xx0x/vk49/README.md

# VK49 2.0

Made by Vaclav Mach (vaclavmach at hotmail.cz)

## License 

- Hardware: CC BY-SA 4.0
- Software: CC BY-SA 4.0
- Original sounds: Copyrighted
