xx0x/vk49/hardware/VK49_2.0.brd

## EAGLE design hardware/VK49_2.0.brd (2023-06-04)

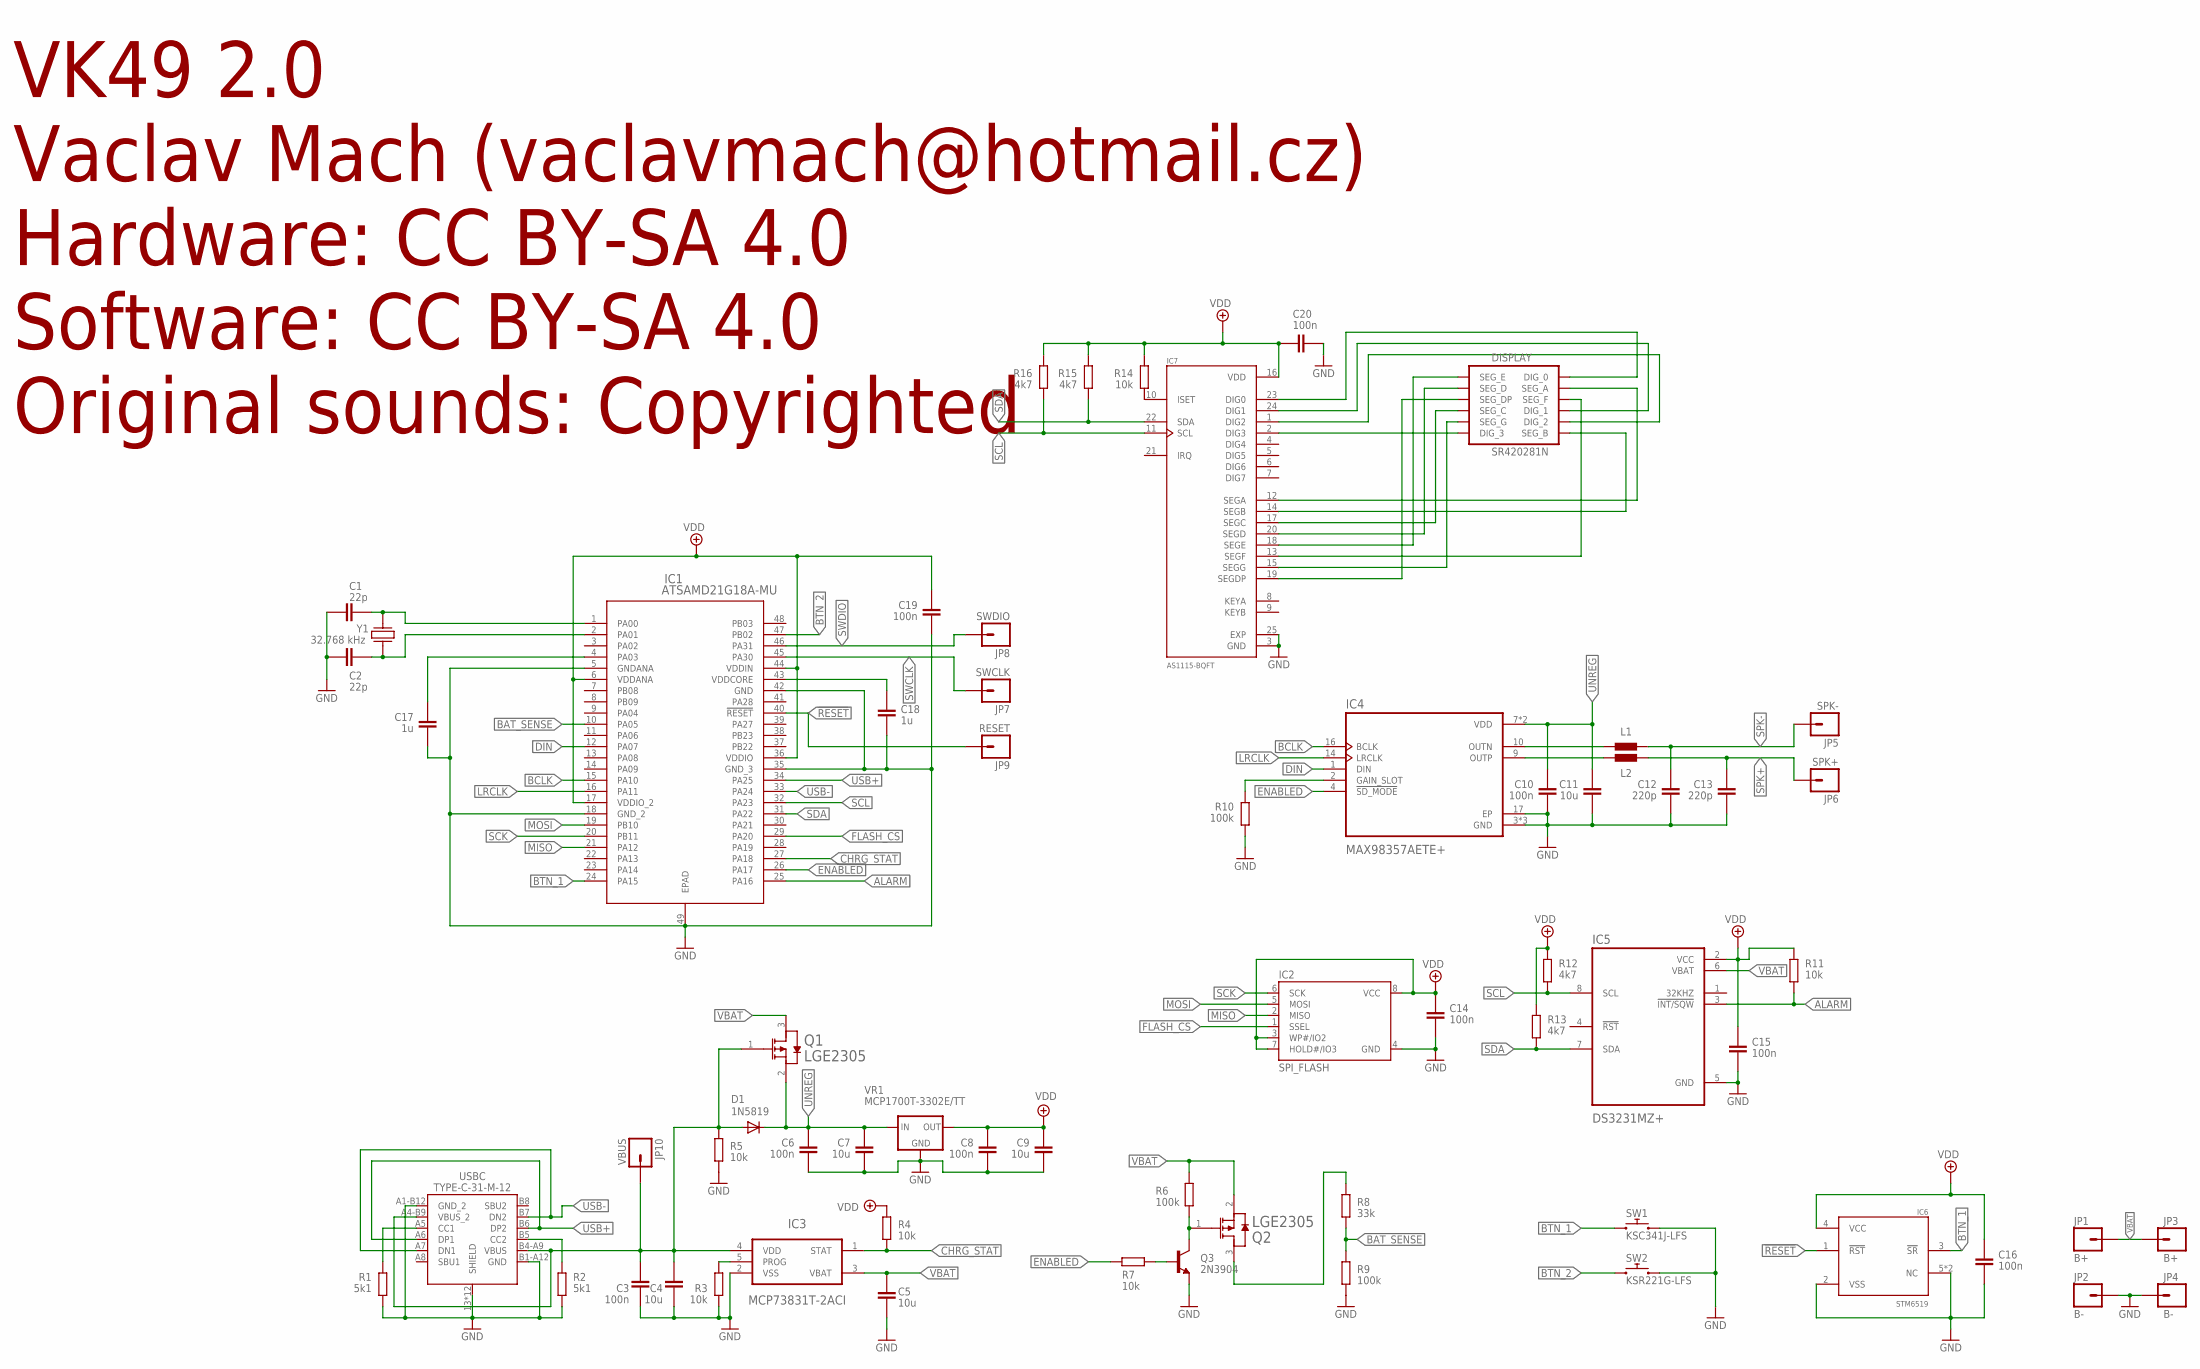
[picture p1: schematic VK49_2.0.sch]

Parts:
C1, C2: 22p; CAPACITOR0603
C3, C6, C8, C10, C14, C15, C16, C19, C20: 100n; CAPACITOR0603
C4, C5, C7, C9, C11: 10u; CAPACITOR0805
C12, C13: 220p; CAPACITOR0603
C17, C18: 1u; CAPACITOR0603
D1: 1N5819; SOD123
DISPLAY: SR420281N; SEG_SR420281N_NO-SILK
IC1: ATSAMD21G18A-MU; QFN-48-7X7
IC2: SPI_FLASH; SO08-EIAJ
IC3: MCP73831T-2ACI; SOT23-5
IC4: MAX98357AETE+; QFN50P300X300X80-17N
IC5: DS3231MZ+; SO8
IC6: STM6519; SON50P145X100X65-6N
IC7: AS1115-BQFT; QFN50P400X400X65-25N
JP1, JP3: B+; 1X01_ROUND_NOSILK
JP2, JP4: B-; 1X01_ROUND_NOSILK
JP5: SPK-; 1X01_ROUND_NOSILK
JP6: SPK+; 1X01_ROUND_NOSILK
JP7: SWCLK; 1X01_ROUND_NOSILK
JP8: SWDIO; 1X01_ROUND_NOSILK
JP9: RESET; 1X01_ROUND_NOSILK
JP10: VBUS; 1X01_ROUND_NOSILK
L1, L2: MMZ1608B121CTAH0; 0603
Q1, Q2: LGE2305; SOT23
Q3: 2N3904; SOT23
R1, R2: 5k1; RESISTOR0603
R3, R4, R5, R7, R11, R14: 10k; RESISTOR0603
R6, R9, R10: 100k; RESISTOR0603
R8: 33k; RESISTOR0603
R12, R13, R15, R16: 4k7; RESISTOR0603
SW1: KSC341J-LFS; KSC3XXJ
SW2: KSR221G-LFS; KSR2XXG
USBC: TYPE-C-31-M-12; USB-C
VR1: MCP1700T-3302E/TT; SOT23
Y1: 32.768 kHz; 3.2X1.5-2-PAD

Connections:
!RESET: IC1.40 (!RESET), IC6.1 (!RST), JP9.1
ALARM: IC1.25 (PA16), IC5.3 (!INT/SQW), R11.1
BAT_SENSE: IC1.10 (PA05), R8.2, R9.1
BCLK: IC1.15 (PA10), IC4.16 (BCLK)
BTN_1: IC1.24 (PA15), IC6.3 (!SR), SW1.1, SW1.3 (1)
BTN_2: IC1.47 (PB02), SW2.1
CHRG_STAT: IC1.27 (PA18), IC3.1 (STAT), R4.1
DIN: IC1.12 (PA07), IC4.1 (DIN)
ENABLED: IC1.26 (PA17), IC4.4 (!SD_MODE), R7.1
FLASH_CS: IC1.29 (PA20), IC2.1 (SSEL)
GND: C1.1, C2.1, C3.1, C4.2, C5.2, C6.1, C7.2, C8.1, C9.2, C10.1, C11.2, C12.1, C13.1, C14.1, C15.1, C16.1, C17.1, C18.1, C19.1, C20.1, IC1.5 (GNDANA), IC1.18 (GND_2), IC1.35 (GND_3), IC1.42 (GND), IC1.49 (EPAD), IC2.4 (GND), IC3.2 (VSS), IC4.3 (GND), IC4.11 (GND), IC4.15 (GND), IC4.17 (EP), IC5.5 (GND), IC6.2 (VSS), IC6.5 (NC), IC6.6 (NC), IC7.3 (GND), IC7.25 (EXP), JP2.1, JP4.1, Q3.2 (E), R1.1, R2.1, R3.2, R5.1, R9.2, R10.1, SW1.2, SW1.4 (2), SW2.2, USBC.13 (SHIELD), USBC.14 (SHIELD), USBC.15 (SHIELD), USBC.16 (SHIELD), USBC.A1-B12 (GND_2), USBC.B1-A12 (GND), USBC.S_1_H1 (SHIELD), USBC.S_1_H2 (SHIELD), USBC.S_2_H1 (SHIELD), USBC.S_2_H2 (SHIELD), USBC.S_3_H1 (SHIELD), USBC.S_3_H2 (SHIELD), USBC.S_4_H1 (SHIELD), USBC.S_4_H2 (SHIELD), VR1.GND
LRCLK: IC1.16 (PA11), IC4.14 (LRCLK)
MISO: IC1.21 (PA12), IC2.2 (MISO)
MOSI: IC1.19 (PB10), IC2.5 (MOSI)
unnamed: C1.2, IC1.1 (PA00), Y1.1
unnamed: C2.2, IC1.2 (PA01), Y1.2
unnamed: IC7.10 (ISET), R14.1
unnamed: R1.2, USBC.A5 (CC1)
unnamed: R2.2, USBC.B5 (CC2)
unnamed: C18.2, IC1.43 (VDDCORE)
unnamed: IC3.5 (PROG), R3.1
unnamed: IC4.10 (OUTN), L1.1
unnamed: IC4.9 (OUTP), L2.1
unnamed: IC4.2 (GAIN_SLOT), R10.2
unnamed: C17.2, IC1.4 (PA03)
unnamed: DISPLAY.12 (DIG_0), IC7.23 (DIG0)
unnamed: DISPLAY.9 (DIG_1), IC7.24 (DIG1)
unnamed: DISPLAY.8 (DIG_2), IC7.1 (DIG2)
unnamed: DISPLAY.6 (DIG_3), IC7.2 (DIG3)
unnamed: DISPLAY.11 (SEG_A), IC7.12 (SEGA)
unnamed: DISPLAY.7 (SEG_B), IC7.14 (SEGB)
unnamed: DISPLAY.4 (SEG_C), IC7.17 (SEGC)
unnamed: DISPLAY.2 (SEG_D), IC7.20 (SEGD)
unnamed: DISPLAY.1 (SEG_E), IC7.18 (SEGE)
unnamed: DISPLAY.10 (SEG_F), IC7.13 (SEGF)
unnamed: DISPLAY.5 (SEG_G), IC7.15 (SEGG)
unnamed: DISPLAY.3 (SEG_DP), IC7.19 (SEGDP)
unnamed: Q2.3 (DRAIN), R8.1
unnamed: Q2.1 (GATE), Q3.3 (C), R6.2
unnamed: Q3.1 (B), R7.2
SCK: IC1.20 (PB11), IC2.6 (SCK)
SCL: IC1.32 (PA23), IC5.8 (SCL), IC7.11 (SCL), R12.1, R16.1
SDA: IC1.31 (PA22), IC5.7 (SDA), IC7.22 (SDA), R13.1, R15.1
SPK+: C13.2, JP6.1, L2.2
SPK-: C12.2, JP5.1, L1.2
SWCLK: IC1.45 (PA30), JP7.1
SWDIO: IC1.46 (PA31), JP8.1
UNREG: C6.2, C7.1, C10.2, C11.1, D1.C, IC4.7 (VDD), IC4.8 (VDD), Q1.2 (SOURCE), VR1.VIN (IN)
USB+: IC1.34 (PA25), USBC.A6 (DP1), USBC.B6 (DP2)
USB-: IC1.33 (PA24), USBC.A7 (DN1), USBC.B7 (DN2)
VBAT: C5.1, IC3.3 (VBAT), IC5.6 (VBAT), JP1.1, JP3.1, Q1.3 (DRAIN), Q2.2 (SOURCE), R6.1
VBUS: C3.2, C4.1, D1.A, IC3.4 (VDD), JP10.1, Q1.1 (GATE), R5.2, USBC.A4-B9 (VBUS_2), USBC.B4-A9 (VBUS)
VDD: C8.2, C9.1, C14.2, C15.2, C16.2, C19.2, C20.2, IC1.6 (VDDANA), IC1.17 (VDDIO_2), IC1.36 (VDDIO), IC1.44 (VDDIN), IC2.3 (WP#/IO2), IC2.7 (HOLD#/IO3), IC2.8 (VCC), IC5.2 (VCC), IC6.4 (VCC), IC7.16 (VDD), R4.2, R11.2, R12.2, R13.2, R14.2, R15.2, R16.2, VR1.VOUT (OUT)

Notes on the sheet:
VK49 2.0 Vaclav Mach (vaclavmach@hotmail.cz) Hardware: CC BY-SA 4.0 Software: CC BY-SA 4.0 Original sounds: Copyrighted

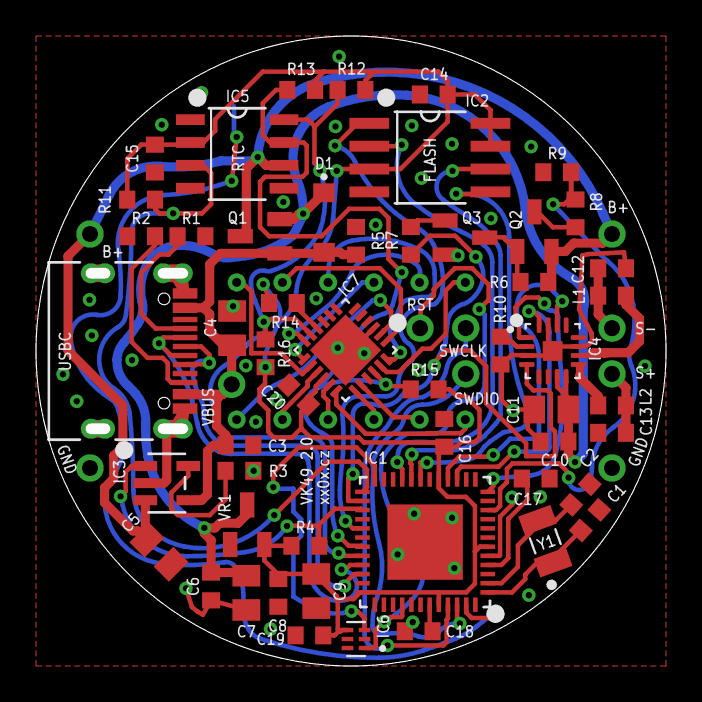
[picture p2: board VK49_2.0.brd from above]

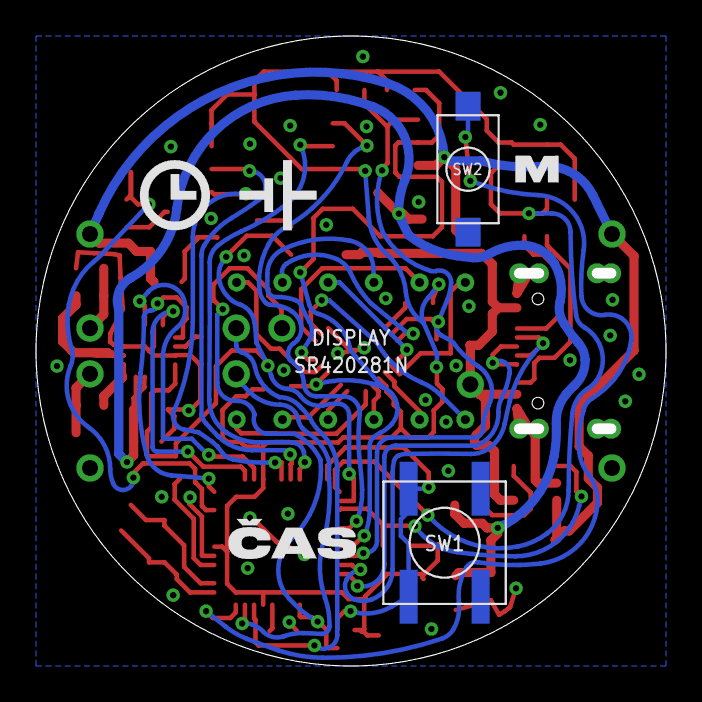
[picture p3: board VK49_2.0.brd from below]

Board: 2 copper layers, 35.0 x 35.0 mm, 65 parts (3 on the bottom side), 53 nets.
