xx0x/vk49/firmware/vk49/pins.h

#define PIN_LED_DATA 10
#define PIN_LED_CLOCK 11
#define PIN_LED_LATCH 12
#define PIN_STATUS_LED 13
#define PIN_FLASH_CS 6
#define PIN_ENABLE 16
#define PIN_BUTTON 5
#define PIN_MENU_BUTTON 19
#define PIN_ALARM 15
#define PIN_BATSENSE 18
#define PIN_I2S_FS 0  // LRC
#define PIN_I2S_SCK 1 // BCLK
#define PIN_I2S_TX 9  // DIN
#define PIN_I2S_RX 2  // BCLK -- not used
