xx0x/vk49/firmware/vk49/flash.h

#define DISPLAY_SHOW_FLASHING false

uint32_t currentFlashCount = 0;
uint32_t flashAddress = 0;
bool flashDisplayActive = false;

uint32_t flashReadInt(uint32_t address)
{
    byte buff[4];
    flash.readByteArray(address, buff, 4);
    return buff[0] << 24 | buff[1] << 16 | buff[2] << 8 | buff[3];
}

bool flashSetup()
{

    Serial.print("Flash manufacturer: ");
    Serial.println(flash.getManID());
    Serial.print("Flash JEDEC ID: ");
    Serial.println(flash.getJEDECID());
    Serial.print("Flash capacity: ");
    Serial.println(flash.getCapacity());

    uint32_t flashHeaderLength = flashReadInt(0);
    Serial.print("Data header length: ");
    Serial.println(flashHeaderLength);

    if (flashHeaderLength > MAX_HEADER_SIZE)
    {
        Serial.println("Header too long, ignoring...");
        return false;
    }

    uint32_t prevAddress = flashHeaderLength;

    // clear old stuff
    for (byte i = 0; i < MAX_SAMPLES; i++)
    {
        samplesOffsets[i] = 0;
        samplesLenghts[i] = 0;
    }

    // clear old alarms
    alarmsCount = 0;

    // read new data
    for (uint16_t i = 4; i < flashHeaderLength; i += 5)
    {
        byte num = flash.readByte(i);
        if (num >= MAX_SAMPLES)
        {
            break;
        }
        samplesOffsets[num] = prevAddress;
        samplesLenghts[num] = flashReadInt(i + 1);
        prevAddress += samplesLenghts[num];
        if (num >= SAMPLE_ALARM_BASE)
        {
            alarmsCount++;
        }
    }

    // check alarm, whether available
    if (currentAlarm >= alarmsCount)
    {
        currentAlarm = 0;
    }

    // display new data
    for (byte i = 0; i < MAX_SAMPLES; i++)
    {
        if (samplesLenghts[i] != 0)
        {
            Serial.print("Sample ");
            if (i < 10)
            {
                Serial.print(" ");
            }
            Serial.print(i);
            Serial.print(": offset ");
            Serial.print(samplesOffsets[i]);
            Serial.print(", length ");
            Serial.println(samplesLenghts[i]);
        }
    }
    Serial.print("Found alarms: ");
    Serial.println(alarmsCount);

    return true;
}

void flashProcessByte(byte data)
{
    buffer[currentFlashCount] = data;
    if (currentFlashCount >= BUFFER_SIZE)
    {
        flash.writeByteArray(flashAddress - currentFlashCount, buffer, currentFlashCount);
        Serial.print("Bytes written: ");
        Serial.println(flashAddress);
        currentFlashCount = 0;
#if DISPLAY_SHOW_FLASHING
        flashDisplayActive = !flashDisplayActive;
        if (flashDisplayActive)
        {
            displayFlash((uint16_t)(flashAddress / 10486));
        }
        else
        {
            displayClear();
        }
#endif
    }
    else
    {
        currentFlashCount++;
    }
    flashAddress++;
}

void flashStart()
{
    delay(20);
    displayFlash();
    delay(20);
    flashAddress = 0;
    currentFlashCount = 0;
    Serial.print("Flash manufacturer: ");
    Serial.println(flash.getManID());
    Serial.print("Flash JEDEC ID: ");
    Serial.println(flash.getJEDECID());
    Serial.print("Flash capacity: ");
    Serial.println(flash.getCapacity());
    Serial.println("Erasing chip");
    flash.eraseChip();
    Serial.println("Chip erased");
    Serial.println("Starting flashing");
}

void flashEnd()
{
    Serial.println("Flashing ended");
    if (flashAddress > 0)
    {
        flash.writeByteArray(flashAddress - currentFlashCount, buffer, currentFlashCount); // write remainings
        Serial.print("Total bytes: ");
        Serial.println(flashAddress);
        displayClear();
        flashSetup();
    }
}
