xx0x/vk49/(commit log)

2020-07-14 correct saySample return value
    [say.h]
2020-07-22 flash memory powerdown / powerup
2020-07-22 display alarm and time in menu, flash sleep fix
    [vk49.ino]
2020-08-14 buttons timing update
2020-08-29 add menu timeout, fix timesetting to prevent invalid values
    [digits.h, display.h, vk49.ino]
2020-12-05 updates for new samples
2020-12-14 update button timeout when sleep
2021-01-05 change code to use AS1115 LED driver
2021-01-14 fix weird display issues by adding delays
    [display.h, vk49.ino]
2021-01-18 disable message flashing to prevent upload errors
    [flash.h]
2021-01-18 dont continue saying time when interrupted after setting
2021-08-09 fix millis overflow issue
    [vk49.ino]
2023-04-30 2.0 hw proposal
    [VK49_2.0.brd, VK49_2.0.sch]
2023-04-30 2.0 board in progress
    [VK49_2.0.brd, VK49_2.0.sch]
2023-05-01 2.0 board routing
    [VK49_2.0.brd, VK49_2.0.sch]
2023-05-01 board update
    [VK49_2.0.brd]
2023-05-09 finalize, add gerber
    [VK49_2.0.brd]
2023-06-04 resistor updates
    [VK49_2.0.brd, VK49_2.0.sch]
2023-06-04 better battery reading
