xx0x/vk49/(notices)

Notices in the files:
parts and their libraries:
COPYRIGHT: Copyright (C) 2022 Ultra Librarian. All rights reserved.
